Tinkerforge/servo-v2-bricklet/hardware/servo-v2.FCStd

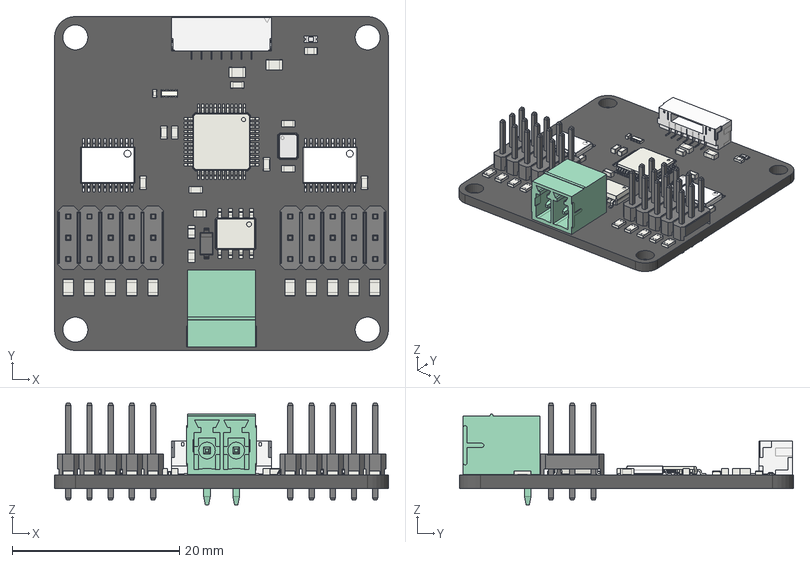
[picture p1: CAD file, 2021-05-28]
hardware/servo-v2.FCStd
40.0 x 40.0 x 12.2 mm
Pcb_9f1d
U9_PLT_(DS1021_CONNFLY)_5D094F40
U8_PLT_(DS1021_CONNFLY)_5D093721
U1_lqfp48_7x7_p05_5D095C34
C1_C_0805_5D0934F0
C2_C_0603_5D0934FA
C3_C_0603_5D68E059
C4_C_0603_5D09350E
C5_C_0603_5D13868B
C6_C_0603_5D093522
C7_C_0402_5D09352C
C8_C_0603_5D095CB9
C9_C_0603_5D095CFB
C10_C_0603_5D09354A
C11_C_0603_5D093554
C12_C_0805_5D09355E
D1_SOD-123_5D093572
D3_D_0603_blue_5D093582
P1_BrickletConn_7pin_5D093595
P4_2er_Phoenix_Buchse_Grün_5D093CA8
Q1_soic_8_39x49_p127_5D0935C1
R1_R_0603_5D0935CB
R2_R_0603_5D0935D5
R3_R_0603_5D0935DF
R4_R_0805_5D094D29
R5_R_0805_5D094D7A
R6_R_0805_5D094D5F
R7_R_0805_5D094D0E
R8_R_0805_5D094D44
R9_R_0805_5D094FCA
R10_R_0805_5D094EAD
R11_R_0805_5D094F6D
R12_R_0805_5D094FAF
R13_R_0805_5D094EC8
R16_R_0603_5D09364D
RP1_Cut_5D09365D
U6_TSSOP-20_5D094DA8
U7_TSSOP-20_5D094EF6
X1_3225_5D095CD8
