Tinkerforge/servo-v2-bricklet/hardware/servo-v2-schematic.pdf

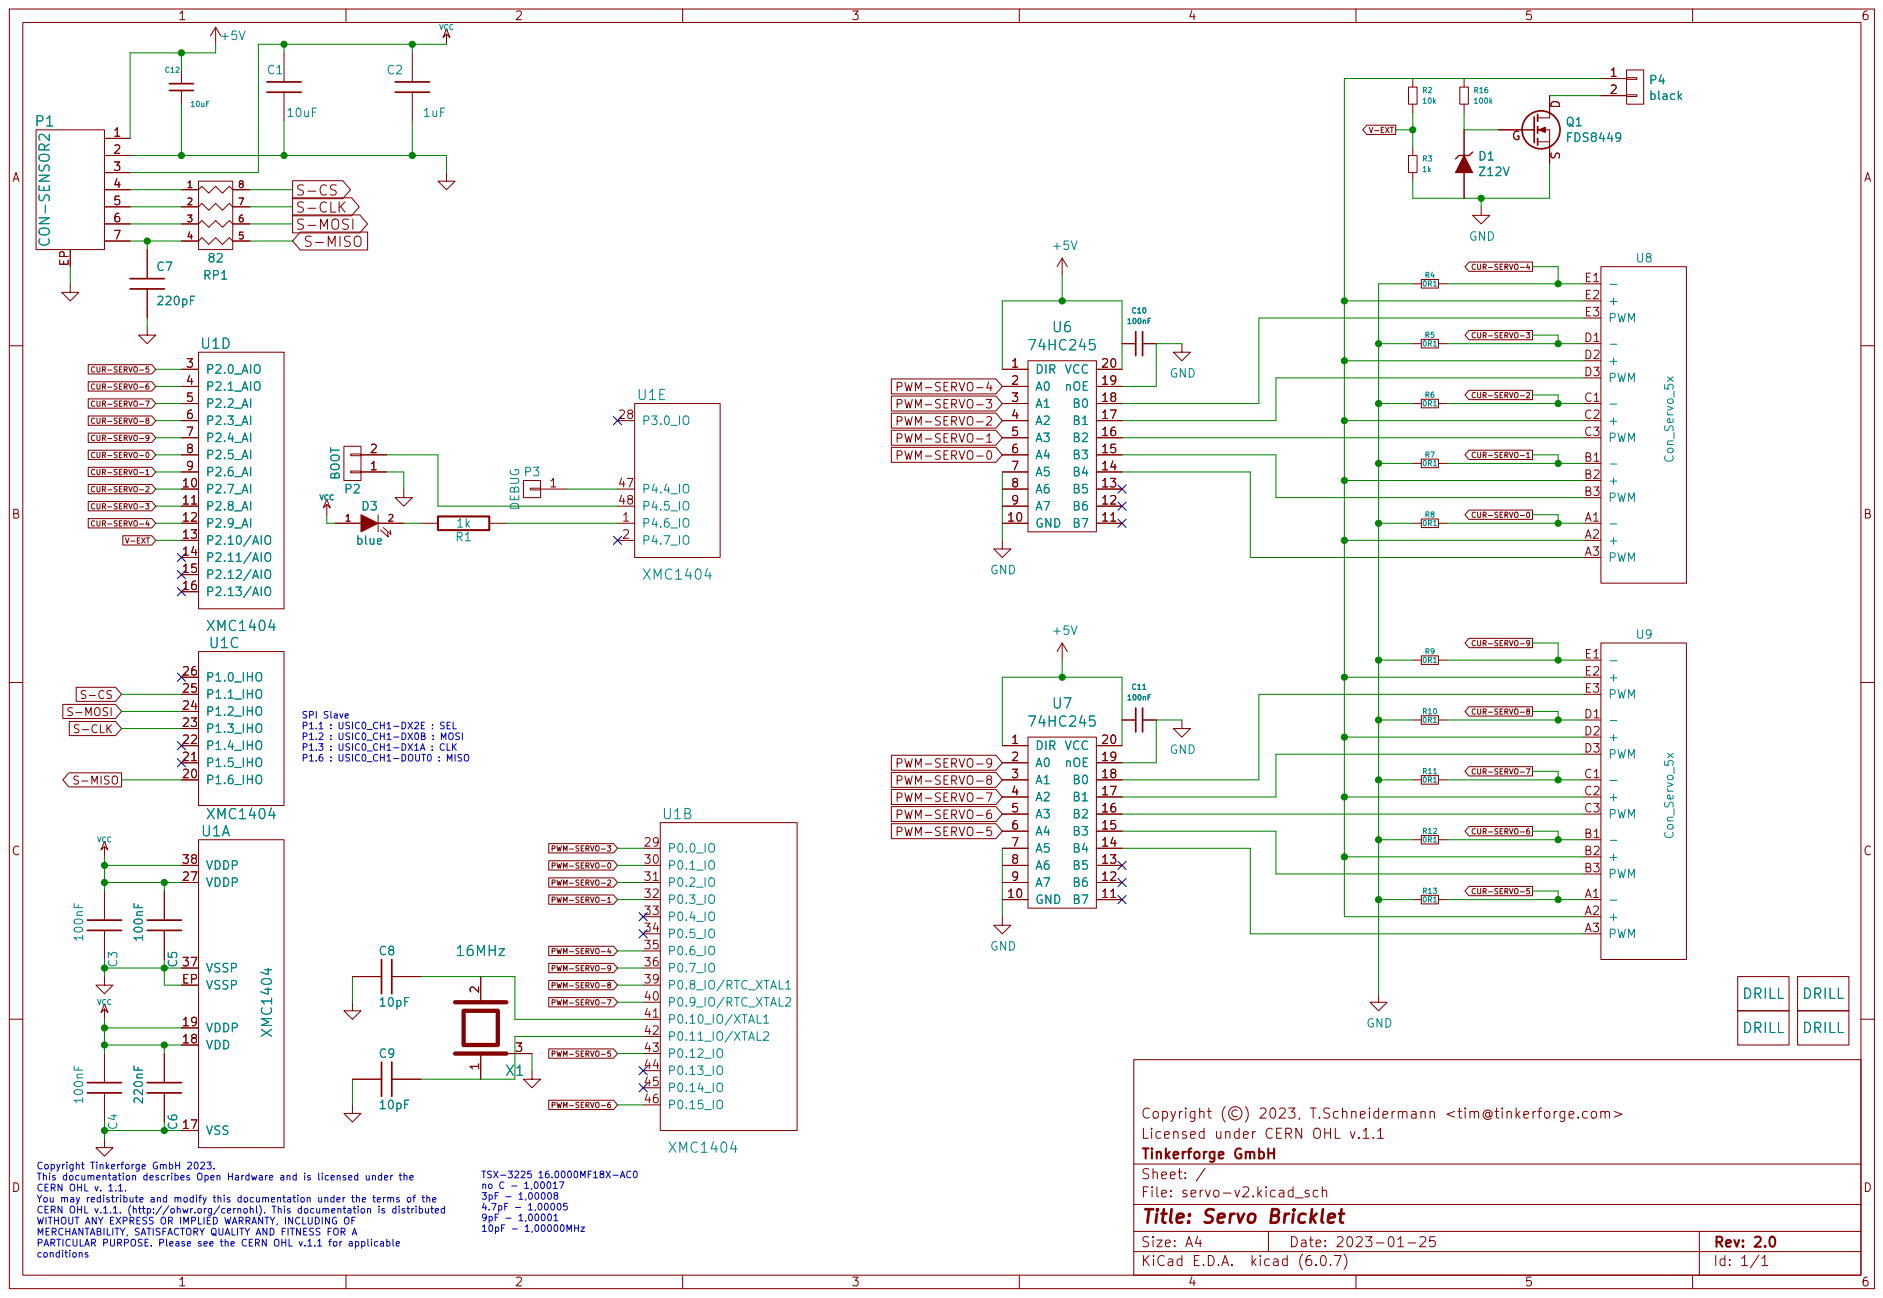
[picture p2: page 1]

CUR-SERVO-9 CUR-SERVO-1

CUR-SERVO-0 S-MISO
PWM-SERVO-3 CUR-SERVO-4 S-CS

SPI Slave P1.1 : USIC0_CH1-DX2E : SEL P1.2 : USIC0_CH1-DX0B : MOSI P1.3 : USIC0_CH1-DX1A : CLK

R11 0R1
CUR-SERVO-7 CUR-SERVO-6 CUR-SERVO-5

PWM-SERVO-0 PWM-SERVO-1
PWM-SERVO-6 PWM-SERVO-9 PWM-SERVO-4

Licensed under CERN OHL v.1.1
File: servo-v2.kicad_sch Sheet: / Tinkerforge GmbH

Id: 1/1 Title: Servo Bricklet

PARTICULAR PURPOSE. Please see the CERN OHL v.1.1 for applicable
