Tinkerforge/servo-v2-bricklet/hardware/servo-v2.kicad_pcb

## KiCad design hardware/servo-v2.kicad_pcb (2023-09-26)

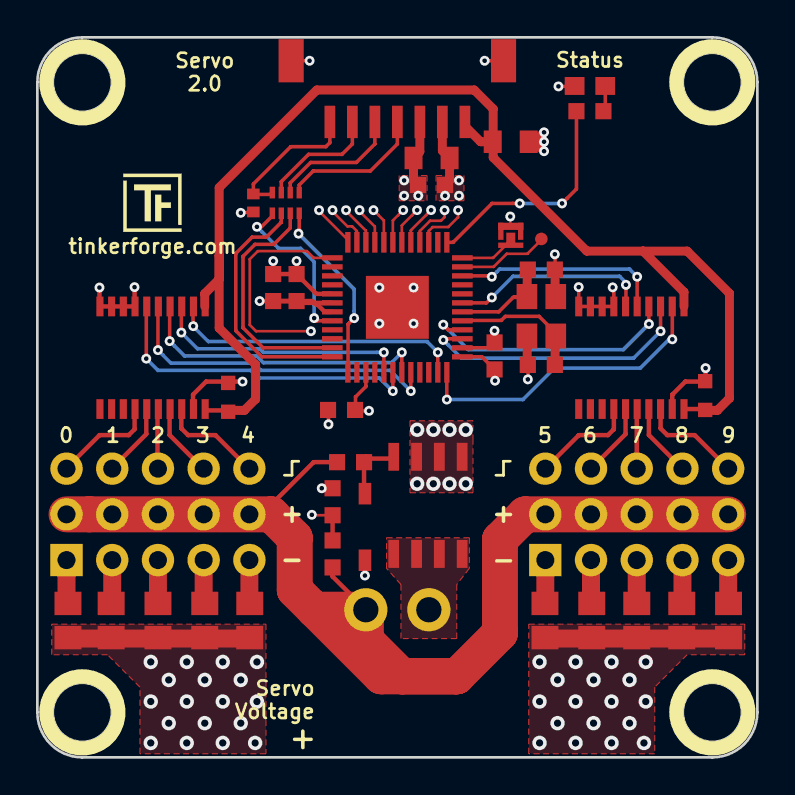
[picture p3: board servo-v2.kicad_pcb from above]

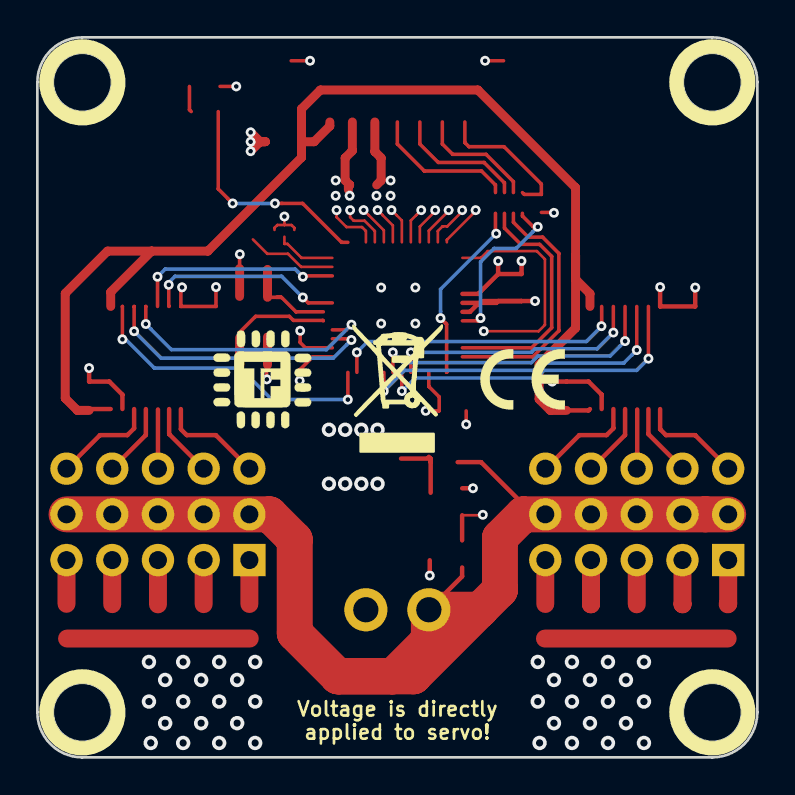
[picture p4: board servo-v2.kicad_pcb from below]

Board: 4 copper layers, 40.0 x 40.0 mm, 46 parts (2 on the bottom side), 51 nets.

Parts:
C1, C12: 10uF; C0805
C2: 1uF; C0603F
C3, C4, C5: 100nF; C0603F
C6: 220nF; C0603F
C7: 220pF; C0402F
C8, C9: 10pF; C0603F
C10, C11: 100nF; C0603
D1: Z12V; SOD-123
D3: blue; D0603E
P1: CON-SENSOR2
P2: BOOT; SolderJumper
P3: DEBUG; DEBUG_PAD
P4: black; OQ_2P
Q1: FDS8449; SOIC-8-MOSFET
R1, R3: 1k; R0603F
R2: 10k; R0603F
R4, R5, R6, R7, R8, R9, R10, R11, R12, R13: 0R1; R0805E
R16: 100k; R0603F
RP1: 82; 4X0402
U1: XMC1404; QFN48-EP2
U2, U3, U4, U5: DRILL; DRILL_NP
U6, U7: 74HC245; TSSOP20
U8, U9: Con_Servo_5x; pin_array_5x3
VAL: CE_5mm
VAL#2: WEEE_7mm
X1: 16MHz; CRYSTAL_3225

Connections:
+5V: C10.1, C11.2, C12.1, P1.1, U6.1, U6.20, U7.1, U7.20
CUR-SERVO-0: R8.1, U1.8, U8.A1
CUR-SERVO-1: R7.1, U1.9, U8.B1
CUR-SERVO-2: R6.1, U1.10, U8.C1
CUR-SERVO-3: R5.1, U1.11, U8.D1
CUR-SERVO-4: R4.1, U1.12, U8.E1
CUR-SERVO-5: R13.1, U1.3, U9.A1
CUR-SERVO-6: R12.1, U1.4, U9.B1
CUR-SERVO-7: R11.1, U1.5, U9.C1
CUR-SERVO-8: R10.1, U1.6, U9.D1
CUR-SERVO-9: R9.1, U1.7, U9.E1
GND: C1.1, C2.1, C3.2, C4.2, C5.2, C6.2, C7.2, C8.2, C9.2, C10.2, C11.1, C12.2, D1.1, P1.2, P1.EP, P2.1, Q1.S, R3.2, R4.2, R5.2, R6.2, R7.2, R8.2, R9.2, R10.2, R11.2, R12.2, R13.2, U1.17, U1.37, U1.EP, U6.7, U6.8, U6.9, U6.10, U6.19, U7.7, U7.8, U7.9, U7.10, U7.19, X1.3
unnamed: C7.1, P1.7, RP1.4
unnamed: C8.1, U1.41, X1.2
unnamed: C9.1, U1.42, X1.1
unnamed: D1.2, Q1.G, R16.1
unnamed: D3.2, R1.2
unnamed: P1.4, RP1.1
unnamed: P1.5, RP1.2
unnamed: P1.6, RP1.3
unnamed: P2.2, U1.48
unnamed: P3.1, U1.47
unnamed: P4.1, R2.1, R16.2, U8.A2, U8.B2, U8.C2, U8.D2, U8.E2, U9.A2, U9.B2, U9.C2, U9.D2, U9.E2
unnamed: P4.2, Q1.D
unnamed: R1.1, U1.1
unnamed: U6.14, U8.A3
unnamed: U6.15, U8.B3
unnamed: U6.16, U8.C3
unnamed: U6.17, U8.D3
unnamed: U6.18, U8.E3
unnamed: U7.14, U9.A3
unnamed: U7.15, U9.B3
unnamed: U7.16, U9.C3
unnamed: U7.17, U9.D3
unnamed: U7.18, U9.E3
PWM-SERVO-0: U1.30, U6.6
PWM-SERVO-1: U1.32, U6.5
PWM-SERVO-2: U1.31, U6.4
PWM-SERVO-3: U1.29, U6.3
PWM-SERVO-4: U1.35, U6.2
PWM-SERVO-5: U1.43, U7.6
PWM-SERVO-6: U1.46, U7.5
PWM-SERVO-7: U1.40, U7.4
PWM-SERVO-8: U1.39, U7.3
PWM-SERVO-9: U1.36, U7.2
S-CLK: RP1.7, U1.23
S-CS: RP1.8, U1.25
S-MISO: RP1.5, U1.20
S-MOSI: RP1.6, U1.24
V-EXT: R2.2, R3.1, U1.13
VCC: C1.2, C2.2, C3.1, C4.1, C5.1, C6.1, D3.1, P1.3, U1.18, U1.19, U1.27, U1.38
