Tinkerforge/servo-v2-bricklet/software/src/pwm.c

/* servo-v2-bricklet
 * Copyright (C) 2019 Olaf Lüke <olaf@tinkerforge.com>
 *
 * pwm.c: Driver for PWM output
 *
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
 * You should have received a copy of the GNU Lesser General Public
 * License along with this library; if not, write to the
 * Free Software Foundation, Inc., 59 Temple Place - Suite 330,
 * Boston, MA 02111-1307, USA.
 */

#include "pwm.h"

#include "bricklib2/hal/system_timer/system_timer.h"
#include "bricklib2/utility/util_definitions.h"

#include "xmc_scu.h"

#include "current.h"

// us to compare/period value:
// CP = US*1000*1000*1000*96/(1000*1000*1000*PRESCALER)
//    = US*96/PRESCALER
#define PWM_US_TO_PERIOD(US, PRESCALER) (((US)*96)/(1 << (PRESCALER)))

PWM pwm[PWM_NUM] = {
	{ // Channel 0
		.is_ccu4            = true,
		.port               = XMC_GPIO_PORT0,
		.pin                = 1,
		.mode               = XMC_GPIO_MODE_OUTPUT_PUSH_PULL_ALT4,
		.ccu4_module        = CCU40,
		.ccu4_slice         = CCU40_CC41,
		.ccu4_slice_number  = 1,
		.ccu4_transfer_mask = XMC_CCU4_SHADOW_TRANSFER_SLICE_1 | XMC_CCU4_SHADOW_TRANSFER_PRESCALER_SLICE_1
	},
	{ // Channel 1
		.is_ccu4            = true,
		.port               = XMC_GPIO_PORT0,
		.pin                = 3,
		.mode               = XMC_GPIO_MODE_OUTPUT_PUSH_PULL_ALT4,
		.ccu4_module        = CCU40,
		.ccu4_slice         = CCU40_CC43,
		.ccu4_slice_number  = 3,
		.ccu4_transfer_mask = XMC_CCU4_SHADOW_TRANSFER_SLICE_3 | XMC_CCU4_SHADOW_TRANSFER_PRESCALER_SLICE_3
	},
	{ // Channel 2
		.is_ccu4            = true,
		.port               = XMC_GPIO_PORT0,
		.pin                = 2,
		.mode               = XMC_GPIO_MODE_OUTPUT_PUSH_PULL_ALT4,
		.ccu4_module        = CCU40,
		.ccu4_slice         = CCU40_CC42,
		.ccu4_slice_number  = 2,
		.ccu4_transfer_mask = XMC_CCU4_SHADOW_TRANSFER_SLICE_2 | XMC_CCU4_SHADOW_TRANSFER_PRESCALER_SLICE_2
	},
	{ // Channel 3
		.is_ccu4            = true,
		.port               = XMC_GPIO_PORT0,
		.pin                = 0,
		.mode               = XMC_GPIO_MODE_OUTPUT_PUSH_PULL_ALT4,
		.ccu4_module        = CCU40,
		.ccu4_slice         = CCU40_CC40,
		.ccu4_slice_number  = 0,
		.ccu4_transfer_mask = XMC_CCU4_SHADOW_TRANSFER_SLICE_0 | XMC_CCU4_SHADOW_TRANSFER_PRESCALER_SLICE_0
	},
	{ // Channel 4
		.is_ccu4            = true,
		.port               = XMC_GPIO_PORT0,
		.pin                = 6,
		.mode               = XMC_GPIO_MODE_OUTPUT_PUSH_PULL_ALT9,
		.ccu4_module        = CCU41,
		.ccu4_slice         = CCU41_CC40,
		.ccu4_slice_number  = 0,
		.ccu4_transfer_mask = XMC_CCU4_SHADOW_TRANSFER_SLICE_0 | XMC_CCU4_SHADOW_TRANSFER_PRESCALER_SLICE_0
	},
	{ // Channel 5
		.is_ccu4            = false,
		.port               = XMC_GPIO_PORT0,
		.pin                = 12,
		.mode               = XMC_GPIO_MODE_OUTPUT_PUSH_PULL_ALT7,
		.ccu8_module        = CCU80,
		.ccu8_channel       = XMC_CCU8_SLICE_COMPARE_CHANNEL_1,
		.ccu8_slice         = CCU80_CC82,
		.ccu8_slice_number  = 2,
		.ccu8_transfer_mask = XMC_CCU8_SHADOW_TRANSFER_SLICE_2 | XMC_CCU8_SHADOW_TRANSFER_PRESCALER_SLICE_2
	},
	{ // Channel 6
		.is_ccu4            = false,
		.port               = XMC_GPIO_PORT0,
		.pin                = 15,
		.mode               = XMC_GPIO_MODE_OUTPUT_PUSH_PULL_ALT5,
		.ccu8_module        = CCU80,
		.ccu8_channel       = XMC_CCU8_SLICE_COMPARE_CHANNEL_1,
		.ccu8_slice         = CCU80_CC83,
		.ccu8_slice_number  = 3,
		.ccu8_transfer_mask = XMC_CCU4_SHADOW_TRANSFER_SLICE_3 | XMC_CCU4_SHADOW_TRANSFER_PRESCALER_SLICE_3
	},
	{ // Channel 7
		.is_ccu4            = true,
		.port               = XMC_GPIO_PORT0,
		.pin                = 9,
		.mode               = XMC_GPIO_MODE_OUTPUT_PUSH_PULL_ALT9,
		.ccu4_module        = CCU41,
		.ccu4_slice         = CCU41_CC43,
		.ccu4_slice_number  = 3,
		.ccu4_transfer_mask = XMC_CCU4_SHADOW_TRANSFER_SLICE_3 | XMC_CCU4_SHADOW_TRANSFER_PRESCALER_SLICE_3
	},
	{ // Channel 8
		.is_ccu4            = true,
		.port               = XMC_GPIO_PORT0,
		.pin                = 8,
		.mode               = XMC_GPIO_MODE_OUTPUT_PUSH_PULL_ALT9,
		.ccu4_module        = CCU41,
		.ccu4_slice         = CCU41_CC42,
		.ccu4_slice_number  = 2,
		.ccu4_transfer_mask = XMC_CCU4_SHADOW_TRANSFER_SLICE_2 | XMC_CCU4_SHADOW_TRANSFER_PRESCALER_SLICE_2
	},
	{ // Channel 9
		.is_ccu4            = true,
		.port               = XMC_GPIO_PORT0,
		.pin                = 7,
		.mode               = XMC_GPIO_MODE_OUTPUT_PUSH_PULL_ALT9,
		.ccu4_module        = CCU41,
		.ccu4_slice         = CCU41_CC41,
		.ccu4_slice_number  = 1,
		.ccu4_transfer_mask = XMC_CCU4_SHADOW_TRANSFER_SLICE_1 | XMC_CCU4_SHADOW_TRANSFER_PRESCALER_SLICE_1
	}
};


// Period value is the amount of clock cycles per period
void pwm_init_channel(const PWM *conf) {
	if(conf->is_ccu4) {
		const XMC_CCU4_SLICE_COMPARE_CONFIG_t compare_config = {
			.timer_mode          = XMC_CCU4_SLICE_TIMER_COUNT_MODE_EA,
			.monoshot            = false,
			.shadow_xfer_clear   = 0,
			.dither_timer_period = 0,
			.dither_duty_cycle   = 0,
			.prescaler_mode      = XMC_CCU4_SLICE_PRESCALER_MODE_NORMAL,
			.mcm_enable          = 0,
			.prescaler_initval   = conf->prescaler,
			.float_limit         = 0,
			.dither_limit        = 0,
			.passive_level       = XMC_CCU4_SLICE_OUTPUT_PASSIVE_LEVEL_HIGH,
			.timer_concatenation = 0
		};

		XMC_CCU4_Init(conf->ccu4_module, XMC_CCU4_SLICE_MCMS_ACTION_TRANSFER_PR_CR);
		XMC_CCU4_StartPrescaler(conf->ccu4_module);
		XMC_CCU4_SLICE_CompareInit(conf->ccu4_slice, &compare_config);

		XMC_CCU4_EnableShadowTransfer(conf->ccu4_module, conf->ccu4_transfer_mask);

		XMC_CCU4_EnableClock(conf->ccu4_module, conf->ccu4_slice_number);
		XMC_CCU4_SLICE_StartTimer(conf->ccu4_slice);
	} else {
		const XMC_CCU8_SLICE_COMPARE_CONFIG_t compare_config = {
			.timer_mode          = XMC_CCU8_SLICE_TIMER_COUNT_MODE_EA,
			.monoshot            = false,
			.shadow_xfer_clear   = 0,
			.dither_timer_period = 0,
			.dither_duty_cycle   = 0,
			.prescaler_mode      = XMC_CCU8_SLICE_PRESCALER_MODE_NORMAL,
			.prescaler_initval   = conf->prescaler,
			.float_limit         = 0,
			.dither_limit        = 0,
			.passive_level_out0  = XMC_CCU8_SLICE_OUTPUT_PASSIVE_LEVEL_HIGH,
			.passive_level_out1  = XMC_CCU8_SLICE_OUTPUT_PASSIVE_LEVEL_HIGH,
			.passive_level_out2  = XMC_CCU8_SLICE_OUTPUT_PASSIVE_LEVEL_HIGH,
			.passive_level_out3  = XMC_CCU8_SLICE_OUTPUT_PASSIVE_LEVEL_HIGH,
			.timer_concatenation = 0
		};

		XMC_CCU8_Init(conf->ccu8_module, XMC_CCU8_SLICE_MCMS_ACTION_TRANSFER_PR_CR);
		XMC_CCU8_StartPrescaler(conf->ccu8_module);
		XMC_CCU8_SLICE_CompareInit(conf->ccu8_slice, &compare_config);

		XMC_CCU8_EnableShadowTransfer(conf->ccu8_module, conf->ccu8_transfer_mask);

		XMC_CCU8_EnableClock(conf->ccu8_module, conf->ccu8_slice_number);
		XMC_CCU8_SLICE_StartTimer(conf->ccu8_slice);
	}
}

void pwm_set_period_match(const PWM *conf, const uint32_t period_value, const uint32_t prescaler) {
	if(conf->is_ccu4) {
		conf->ccu4_slice->PSC = prescaler;
		XMC_CCU4_SLICE_SetTimerPeriodMatch(conf->ccu4_slice, period_value-1);
	} else {
		conf->ccu8_slice->PSC = prescaler;
		XMC_CCU8_SLICE_SetTimerPeriodMatch(conf->ccu8_slice, period_value-1);
	}
}

void pwm_set_compare_match(const PWM *conf, const uint16_t compare_value) {
	if(conf->is_ccu4) {
		XMC_CCU4_SLICE_SetTimerCompareMatch(conf->ccu4_slice, compare_value);
	} else {
		XMC_CCU8_SLICE_SetTimerCompareMatch(conf->ccu8_slice, conf->ccu8_channel, compare_value);
	}
}

void pwm_enable_shadow_transfer(const PWM *conf) {
	if(conf->is_ccu4) {
		XMC_CCU4_EnableShadowTransfer(conf->ccu4_module, conf->ccu4_transfer_mask);
	} else {
		XMC_CCU8_EnableShadowTransfer(conf->ccu8_module, conf->ccu8_transfer_mask);
	}
}

void pwm_init(void) {
	for(uint8_t i = 0; i < PWM_NUM; i++) {
		pwm[i].enabled          = false;
		pwm[i].position         = 0;     // °/100
		pwm[i].current_position = 0;     // °/100
		pwm[i].velocity         = 100000; // °/100s
		pwm[i].current_velocity = 0;     // °/100s
		pwm[i].acceleration     = 50000; // °/100s^2
		pwm[i].deceleration     = 50000; // °/100s^2
		pwm[i].pulse_width_min  = 1000;  // us
		pwm[i].pulse_width_max  = 2000;  // us
		pwm[i].degree_min       = -9000; // °/100
		pwm[i].degree_max       = 9000;  // °/100
		pwm[i].period           = 19500; // us

		pwm[i].prescaler        = XMC_CCU4_SLICE_PRESCALER_32;

		pwm[i].new_enabled      = true;
		pwm[i].new_position     = true;
		pwm[i].new_motion       = true;
		pwm[i].new_pulse_width  = true;
		pwm[i].new_degree       = true;
		pwm[i].new_period       = true;

		pwm[i].last_time        = 0;
		pwm[i].position_calc    = 0.0;

		pwm_init_channel(&pwm[i]);
	}
}

void pwm_motion_planning(PWM *pwm) {
	// We do the motion planning 250 times per second (every 4ms) 
	if(!system_timer_is_time_elapsed_ms(pwm->last_time, 4)) {
		return;
	}
	pwm->last_time = system_timer_get_ms();

	if(pwm->pin == 1) {
		XMC_GPIO_ToggleOutput(P4_4);
	}

	if(pwm->current_position != pwm->position) {
		// If either acceleration or deceleration is 0, we go full speed without any acc/deceleration
		if((pwm->acceleration == 0) || (pwm->deceleration == 0)) {
			pwm->velocity_calc    = pwm->velocity;
			pwm->current_velocity = (uint16_t)pwm->velocity_calc;
		} else {
			float seconds_for_deceleration  = pwm->current_velocity/((float)pwm->deceleration);
			float distance_for_deceleration = seconds_for_deceleration*pwm->current_velocity/2;

			// Decelerate
			if(distance_for_deceleration >= ABS(pwm->current_position - pwm->position)) {
				if(pwm->current_velocity != 0) {
					pwm->velocity_calc    = MAX(0, pwm->velocity_calc - pwm->deceleration/250.0);
					pwm->current_velocity = (uint16_t)pwm->velocity_calc;
				} else {
					pwm->position_calc    = pwm->position;
					pwm->current_velocity = 0;
					pwm->velocity_calc    = 0.0;
					return;
				}
			// Accelerate
			} else if(pwm->current_velocity != pwm->velocity) {
				if(pwm->velocity_calc < pwm->velocity) {
					pwm->velocity_calc = MIN(pwm->velocity, pwm->velocity_calc + pwm->acceleration/250.0);
				} else {
					pwm->velocity_calc = MAX(pwm->velocity, pwm->velocity_calc - pwm->acceleration/250.0);
				}
				pwm->current_velocity = (uint16_t)pwm->velocity_calc;
			}
		}

		// If velocity is set to 0, we go directly to the position
		if(pwm->velocity == 0) {
			pwm->position_calc = pwm->position;
			pwm->current_velocity = 0;
			pwm->velocity_calc    = 0.0;
		} else {
			if(pwm->position_calc < pwm->position) {
				pwm->position_calc = MIN(pwm->position, pwm->position_calc + pwm->velocity_calc/250.0);
			} else {
				pwm->position_calc = MAX(pwm->position, pwm->position_calc - pwm->velocity_calc/250.0);
			}
		}
		pwm->new_position = true;
	} else {
		pwm->current_velocity = 0;
		pwm->velocity_calc    = 0.0;
	}
}

void pwm_tick(void) {
	for(uint8_t i = 0; i < PWM_NUM; i++) {
		pwm_motion_planning(&pwm[i]);

		// Update period, degree, and pulse width
		if(pwm[i].new_period || pwm[i].new_degree || pwm[i].new_pulse_width) {
			// Enforce 2ms delay between period start if all periods are set at the same time
			if(i == 0 || system_timer_is_time_elapsed_ms(pwm[i-1].period_update_last, 2)) {
				pwm[i].period_update_last = system_timer_get_ms();
				pwm[i].new_period      = false;
				pwm[i].new_degree      = false;
				pwm[i].new_pulse_width = false;

				// Find prescaler with best resolution
				pwm[i].prescaler = XMC_CCU4_SLICE_PRESCALER_32;
				for(uint8_t prescaler = 0; prescaler < 16; prescaler++) {
					if(PWM_US_TO_PERIOD(pwm[i].period, prescaler) <= UINT16_MAX) {
						pwm[i].prescaler = prescaler;
						break;
					}
				}
				pwm_set_period_match(&pwm[i], PWM_US_TO_PERIOD(pwm[i].period, pwm[i].prescaler), pwm[i].prescaler);

				// When we change the period, degree or pulse width
				// we also have to update the position
				pwm[i].new_position = true;
			 } else {
				 return;
			 }
		}

		// Update position
		if(pwm[i].new_position) {
			pwm[i].new_position = false;

			const bool reached_before = pwm[i].current_position == pwm[i].position;
			pwm[i].current_position   = (int16_t)pwm[i].position_calc;
			const bool reached_after  = pwm[i].current_position == pwm[i].position;

			uint32_t value = SCALE((int64_t)pwm[i].current_position,
								   (int64_t)pwm[i].degree_min,
								   (int64_t)pwm[i].degree_max,
								   (int64_t)PWM_US_TO_PERIOD(pwm[i].pulse_width_min, pwm[i].prescaler),
								   (int64_t)PWM_US_TO_PERIOD(pwm[i].pulse_width_max, pwm[i].prescaler));
			pwm_set_compare_match(&pwm[i], value);
			pwm_enable_shadow_transfer(&pwm[i]);

			if(reached_after && !reached_before && pwm[i].position_reached_enabled) {
				pwm[i].position_reached = true;
			}
		}

		// Update enabled
		if(pwm[i].new_enabled) {
			pwm[i].new_enabled = false;
			if(pwm[i].enabled) {
				XMC_GPIO_CONFIG_t gpio_out_config	= {
					.mode         = pwm[i].mode,
					.output_level = XMC_GPIO_OUTPUT_LEVEL_LOW,
				};

				XMC_GPIO_Init(pwm[i].port, pwm[i].pin, &gpio_out_config);
			} else {
				XMC_GPIO_CONFIG_t gpio_in_config	= {
					.mode             = XMC_GPIO_MODE_INPUT_TRISTATE,
					.input_hysteresis = XMC_GPIO_INPUT_HYSTERESIS_STANDARD
				};

				XMC_GPIO_Init(pwm[i].port, pwm[i].pin, &gpio_in_config);
			}
		}
	}
}
