Tinkerforge/servo-v2-bricklet/(commit log)

2019-06-18 new schematic
    [servo.kicad_pcb, servo.sch]
2019-06-26 pcb design
    [servo.kicad_pcb, servo.sch]
2019-09-02 final prototype design, drc check, silkscreen added
    [servo.kicad_pcb]
2019-09-03 ready for prototype
    [servo.kicad_pcb, servo.sch]
2019-09-06 ordered version
    [servo.kicad_pcb]
2019-09-19 Add initial test firmware with basic PWM support
    [cmake_config_custom.txt]
2020-01-16 Add and implement API
    Position and period/pulse width configuration works.
    Motion planning is still missing currently.
    [communication.c, communication.h, current.c, current.h, pwm.c, pwm.h]
2020-11-04 Use uint32_t for acc/deceleration and velocity
2020-11-04 Use uint64_t for adc sum and allow averaging configuration per channel
2020-11-04 Add motion planning (velocity, acceleration, deceleration)
2020-11-05 Add current calibration support
2021-01-14 Use uint16_t servo_channel in position-reached callback
    Just as everywhere else.
2021-01-14 Add examples
    [ExampleConfiguration.nb.txt, example-configuration.txt]
2021-01-14 java: Add missing import
    [ExampleCallback.java]
2021-01-15 rust: Fix compiler warnings
    [example_callback.rs]
2021-01-18 Add input voltage measurement error calibration
    Currently i don't understand where this error comes from.
    I tested several Servo Bricklets and they all have the
    same measurement error (off by 5000/5400), so we add some
    fixed calibration values for now.
    [current.c]
2021-03-15 added step model
    [servo.kicad_pcb]
2021-05-28 add 3d data
    [servo.FCStd]
2021-05-28 add schematic
2021-05-28 complete rename
    [servo-v2.FCStd, servo-v2.kicad_pcb, servo-v2.sch]
2021-10-25 Update KiCad link
    https://www.kicad.org/blog/2021/10/Avoid-links-to-former-kicad-domain/
2022-04-26 uc: Adapt to bindings changes
    [example_callback.c, example_configuration.c]
2023-01-23 New standart layout. Switched to Kicad 6
    [servo-v2.kicad_pcb, servo-v2.kicad_sch, servo-v2.sch]
2023-01-25 fix symbols
    [servo-v2.kicad_sch]
2023-01-25 Data Cleanup
    [servo-v2.kicad_pcb, servo-v2.kicad_sch]
2023-09-26 moved to kicad 7, updated drill_np
    [servo-v2.kicad_pcb, servo-v2.kicad_sch]
2024-11-21 Fix voltage calculation
