Tinkerforge/servo-v2-bricklet/(notices)

Notices in the files:
hardware/servo-v2.kicad_pcb:
Copyright (©) 2023, T.Schneidermann
hardware/servo-v2.kicad_sch:
Copyright Tinkerforge GmbH 2023.
This documentation describes Open Hardware and is licensed under the
CERN OHL v. 1.1.
